mcy7880/MxL5007-and-STM32F407-SDR-receiver/Doc/block_diagram.pdf

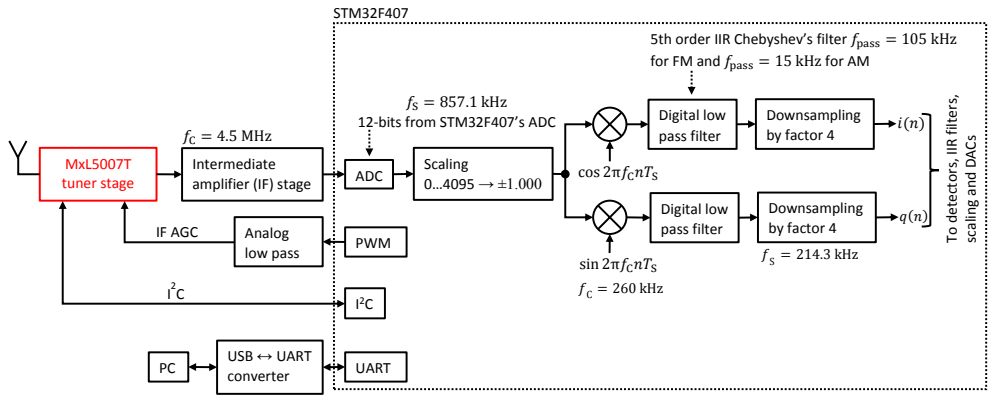
[picture p1: page 1]
MxL5007T tuner stage; ADC; fS = 857.1 kHz; cos 2πfCnTS; Digital low pass filter; Downsampling by factor 4; iሺnሻ; qሺnሻ; = 214.3 kHz sin 2πfCnTS; Scaling 0…4095 → ±1.000; = 260 kHz; STM32F407; Analog low pass; PWM; IF AGC; UART; USB ↔ UART converter PC

5th order IIR Chebyshev’s filter fpass = 105 kHz
for FM and fpass = 15 kHz for AM

To detectors, IIR filters,

12-bits from STM32F407’s ADC

fC = 4.5 MHz
Intermediate
amplifier (IF) stage

scaling and DACs
