mcy7880/MxL5007-and-STM32F407-SDR-receiver/Doc/dvb-t_电路图(MSD7818).pdf

VCC5V_PD | 5V_HDMI

## VC5V

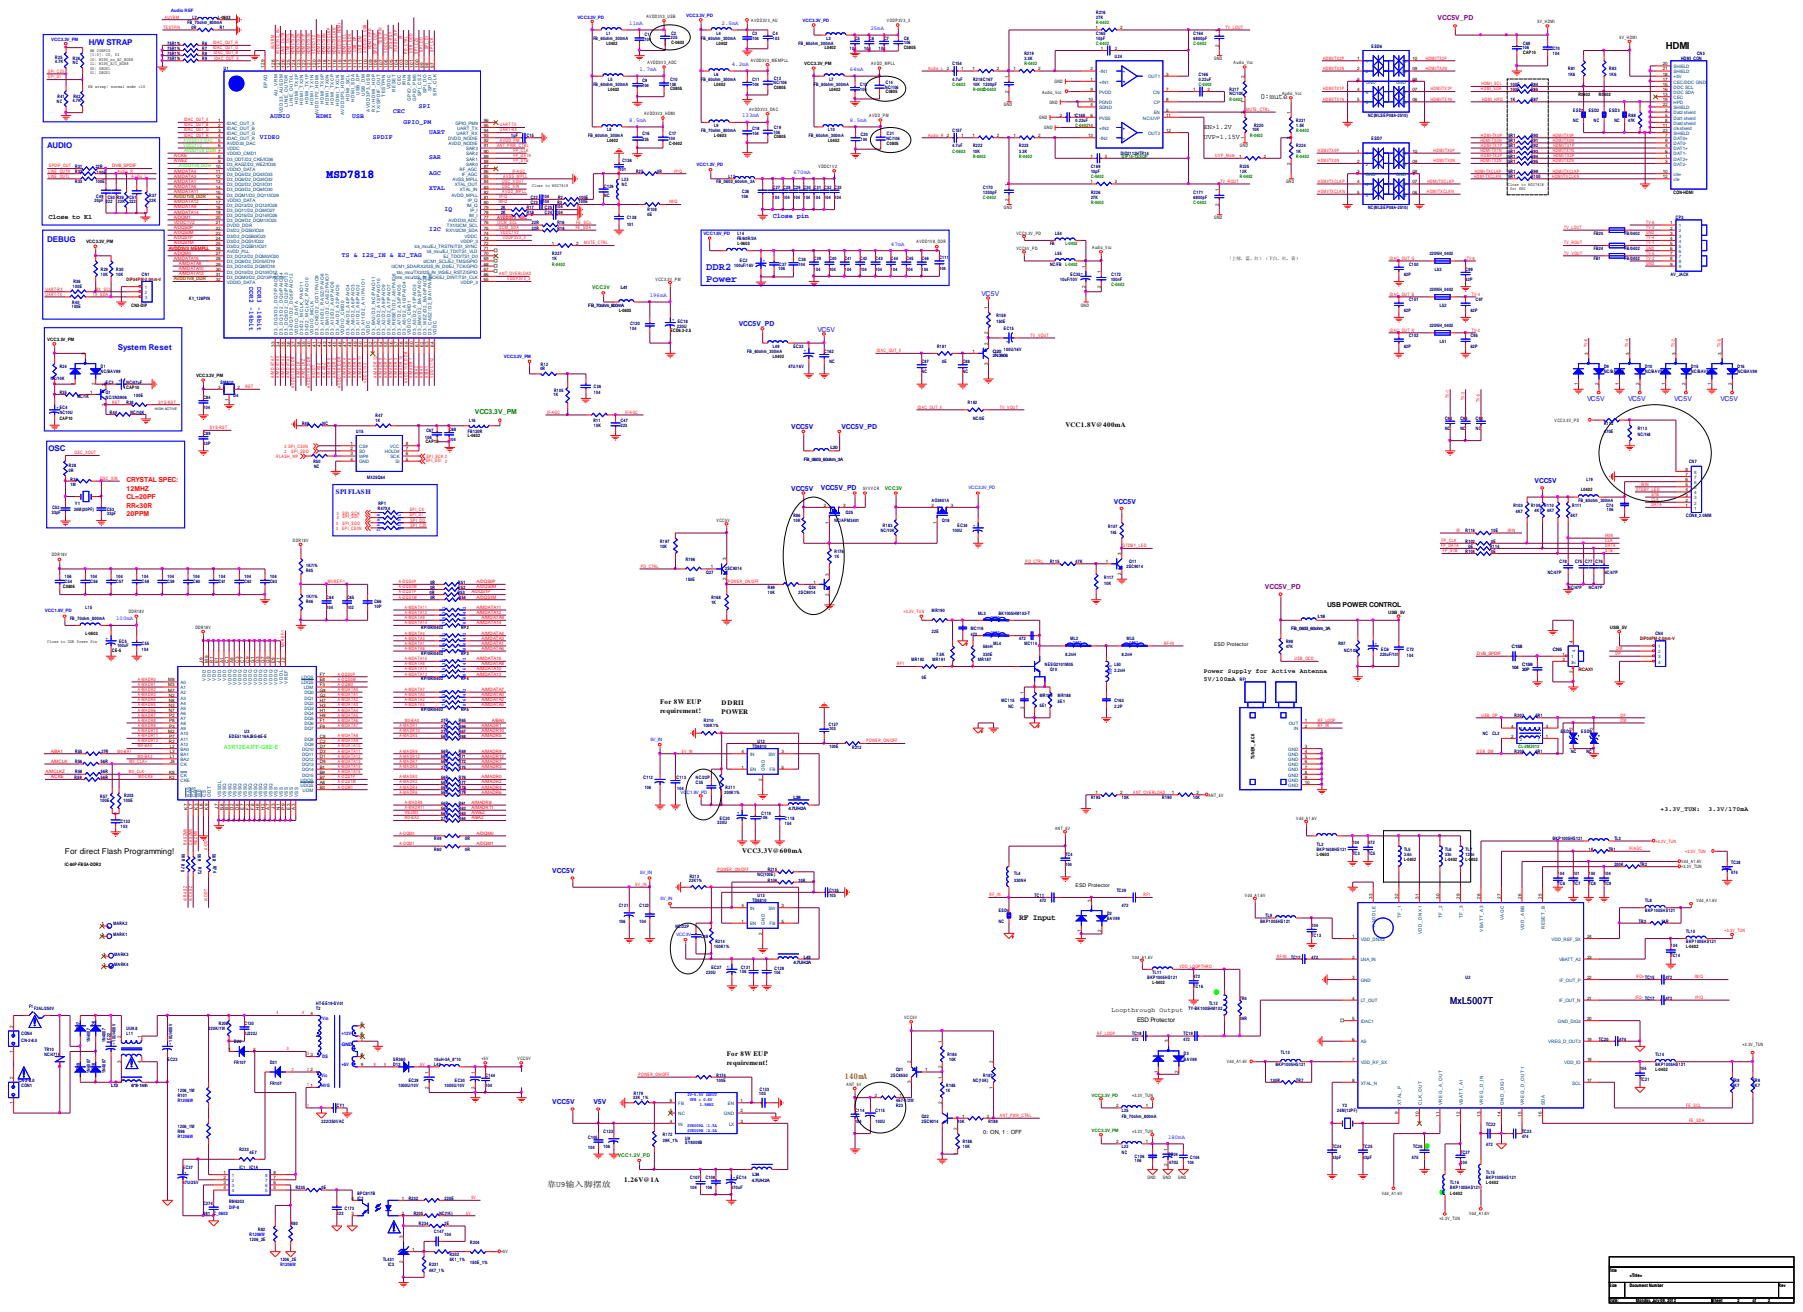
[picture p2: page 1]

HW strap: normal mode =10

Close to DDR Power Pin

VDDQ C7 VDDQ C3 VSSQ D2 VSSQ D8

Power Supply for Active Antenna

For direct Flash Programming!
