mcy7880/MxL5007-and-STM32F407-SDR-receiver/Doc/if_amp_schematic/schematic.pdf

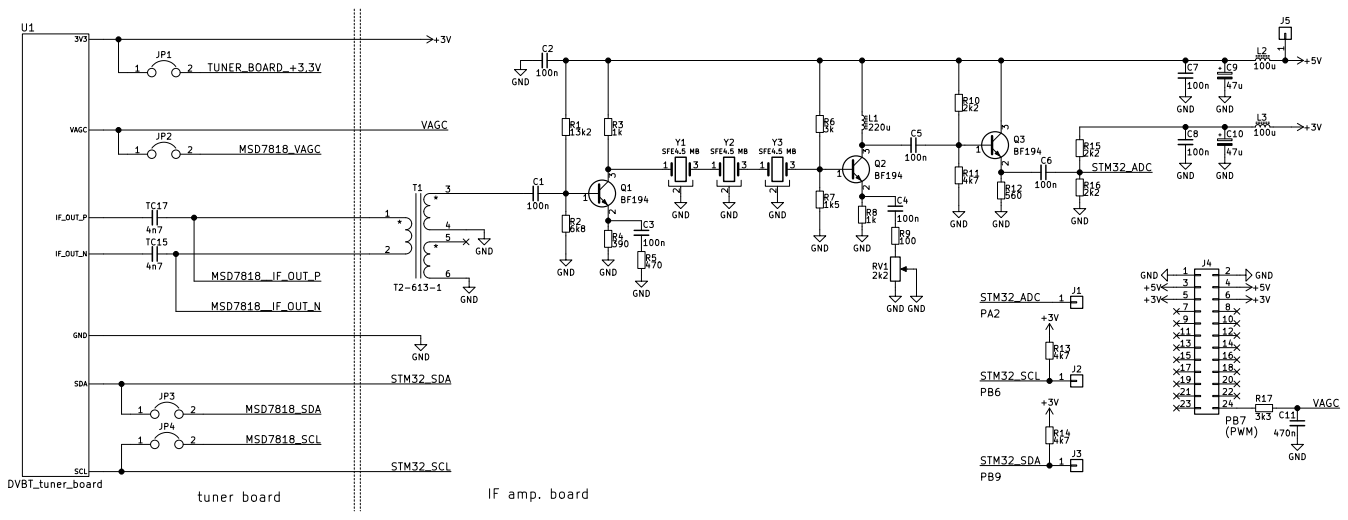
[picture p3: page 1]
