mcy7880/MxL5007-and-STM32F407-SDR-receiver/stm32f407_mxl5007t/Core/Src/main.c

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
/* Includes ------------------------------------------------------------------*/
#include "main.h"

/* USER CODE BEGIN Includes */
#include <string.h>
#include <stdlib.h>
#include <stdio.h>
#include <math.h>
#include <stdbool.h>
#include "led.h"
#include "usart.h"
#include "printf.h"
#include "cmd.h"
#include "MY_CS43L22.h"
#include "MxL5007_Common.h"
#include "MxL5007_API.h"
#include "MxL_User_Define.h"
/* USER CODE END Includes */

ADC_HandleTypeDef hadc1;
DMA_HandleTypeDef hdma_adc1;

DAC_HandleTypeDef hdac;

I2C_HandleTypeDef hi2c1;
I2C_HandleTypeDef hi2c3;

I2S_HandleTypeDef hi2s3;
DMA_HandleTypeDef hdma_spi3_tx;

TIM_HandleTypeDef htim3;
TIM_HandleTypeDef htim4;

UART_HandleTypeDef huart5;

/* USER CODE BEGIN PV */
extern uint8_t rxchar;
int16_t dataI2S[4]; //dummy array for I2S
uint32_t v_in_samples[8]; //IF samples array for ADC

//sine, cosine and arsine look-up tables
float sine_arr[N_cos_sin];
float cosine_arr[N_cos_sin];
float asin_arr[N_asin];

MxL5007_TunerConfigS myTuner; //structure config for MxL5007T

extern Output_demod_type_enum Demod_Type;
extern float b[];
extern float a[];
/* USER CODE END PV */

void SystemClock_Config(void);
static void MX_GPIO_Init(void);
static void MX_DMA_Init(void);
static void MX_I2C1_Init(void);
static void MX_I2S3_Init(void);
static void MX_ADC1_Init(void);
static void MX_TIM3_Init(void);
static void MX_I2C3_Init(void);
static void MX_DAC_Init(void);
static void MX_UART5_Init(void);
static void MX_TIM4_Init(void);
/**
  * @brief  The application entry point.
  * @retval int
  */
int main(void)
{
  /* USER CODE BEGIN 1 */
	//uint8_t regs[32], reg;
	int rxchar_loc;
	uint32_t tick;
  /* USER CODE END 1 */

  /* MCU Configuration--------------------------------------------------------*/

  /* Reset of all peripherals, Initializes the Flash interface and the Systick. */
  HAL_Init();

  /* Configure the system clock */
  SystemClock_Config();

  /* Initialize all configured peripherals */
  MX_GPIO_Init();
  MX_DMA_Init();
  MX_I2C1_Init();
  MX_I2S3_Init();
  MX_ADC1_Init();
  MX_TIM3_Init();
  MX_I2C3_Init();
  MX_DAC_Init();
  MX_UART5_Init();
  MX_TIM4_Init();
  /* USER CODE BEGIN 2 */

  usart_init(&huart5);
  HAL_UART_Receive_IT(&huart5, (uint8_t*) &rxchar, 1);

  /* Startup message */
  UART_printf("\r\n");
  UART_printf("+--------------------------------------+\r\n");
  UART_printf("|     Experimental SDR receiver        |\r\n");
  UART_printf("| based on the STM32F407 and MxL5007T. |\r\n");
  UART_printf("+--------------------------------------+\r\n");

  //init MXL5007T
  myTuner.I2C_Addr = MxL_I2C_ADDR_96; //Set Tuner's I2C Address
  myTuner.Mode = MxL_MODE_DVBT;
  //myTuner.IF_Diff_Out_Level = -8; //Setting for Cable mode only
  myTuner.Xtal_Freq = MxL_XTAL_24_MHZ; //Set Tuner's XTAL freq
  myTuner.IF_Freq = MxL_IF_4_5_MHZ; //Set Tuner's IF Freq
  myTuner.ClkOut_Setting = MxL_CLKOUT_DISABLE; //Set Tuner's Clock out setting
  myTuner.ClkOut_Amp = MxL_CLKOUT_AMP_0;

  HAL_Delay(300); //Without delay after power up MxL5007 doesn't give ACK.
  MxL5007_ChipVersion MxL_ChipVersion = MxL_Check_ChipVersion(&myTuner);
  MxL_Print_ChipVersion(MxL_ChipVersion);
  if (MxL_ChipVersion == MxL_UNKNOWN_ID) MxL_TIMEOUT_UserCallback();

  MxL_ERR_MSG MxL_Status = MxL_Tuner_Init(&myTuner);
  if (MxL_Status != MxL_OK) MxL_TIMEOUT_UserCallback();

  MxL_Status = MxL_Tuner_RFTune(&myTuner, 100*MHz, MxL_BW_6MHz);
  if (MxL_Status != MxL_OK) MxL_TIMEOUT_UserCallback();

  //Check Lock Status
  bool RFSynthLock, REFSynthLock;
  MxL_Status = MxL_RFSynth_Lock_Status(&myTuner, &RFSynthLock);
  if (MxL_Status != MxL_OK) MxL_TIMEOUT_UserCallback();

  MxL_Status = MxL_REFSynth_Lock_Status(&myTuner, &REFSynthLock);
  if (MxL_Status != MxL_OK) MxL_TIMEOUT_UserCallback();

  UART_printf("rfLock=%d   refLock=%d\r\n", RFSynthLock, RFSynthLock);
  UART_printf("MxL5007T initialized.\r\n");

  HAL_TIM_PWM_Start(&htim4, TIM_CHANNEL_2); //starting PWM for IF_AGC pin voltage settings
  MxL_SetGain(75.0 - (IF_Gain + Attenuation)); //total gain 75 dB

  //init CS43L22
  CS43_Init(hi2c1, MODE_ANALOG_);
  CS43_SetVolume(CS43_default_vol); //maximum value without distortion for 3.00 Vpp from DAC is CS43_default_vol=48 for DISCOVERY BOARD
  CS43_Enable_RightLeft(CS43_RIGHT_LEFT);
  CS43_Start();
  UART_printf("CS43L22 initialized.\r\n");

  //TIM3_clk=84 MHz; ARR=98 -> FS_uint_kHz=ceil(TIM3_clk*1000/ARR)=858 kHz
  //F_IF=260 kHz after band pass sampling
  //FS_uint_kHz/F_IF=858/260=33/10 so Step_cos_sin=10 is step and after that is adding modulo N_cos_sin=33 k=mod(k+Step_cos_sin, N_cos_sin)
  float dx = 2.0*M_PI / N_cos_sin; //N_cos_sin=33 samples per sine/cosine period is enough
  uint8_t k = 0;
  for (uint8_t i=0; i<N_cos_sin; i++)
  {
	  sine_arr[i] = sinf(dx*k); //calculating look-up tables with reordering
	  cosine_arr[i] = cosf(dx*k);
	  k = (k + Step_cos_sin) % N_cos_sin; //adding modulo N_cos_sin=33 - unnecessary during real time computing so it can be replace just by counter increment
  }

  dx = 2.0 / N_asin; //step 1-(-1) / N_asin
  for (uint8_t i=0; i<N_asin; i++) asin_arr[i] = asinf(dx*i - 1.0); //calculating look-up table for arsine (needed for FM)

  set_IQ_filters_coeff(b, a, Demod_Type);

  HAL_DAC_Start(&hdac, DAC_CHANNEL_1);
  HAL_DAC_Start(&hdac, DAC_CHANNEL_2);
  HAL_I2S_Transmit_DMA(&hi2s3, (uint16_t *)dataI2S, 4); //starting I2S 16-bits dummy words sending with circular buffer just for MCLK clock for CS43L22

  HAL_TIM_Base_Start(&htim3); //starting timer for ADC triggering
  HAL_ADC_Start_DMA(&hadc1, v_in_samples, 8); //starting DMA for ADC with circular buffer

  /* USER CODE END 2 */

  /* Infinite loop */
  /* USER CODE BEGIN WHILE */
  init_cmd();
  tick = HAL_GetTick() + 100;
  while (1)
  {
    /* USER CODE END WHILE */

    /* USER CODE BEGIN 3 */

	/* UART command processing */
	if((rxchar_loc = usart_getc())!= EOF)
	{
		/* Parse commands */
		cmd_parse(rxchar_loc);
	}

	/* nonblocking wait to flash light */
	if(tick < HAL_GetTick())
	{
		  led_toggle(LED1);
		  tick = HAL_GetTick() + 100;
	}

  }
  /* USER CODE END 3 */
}

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
