mcy7880/MxL5007-and-STM32F407-SDR-receiver/stm32f407_mxl5007t/Core/Inc/main.h

#define IF_Gain         16.95 //dB - measured IF amplifier gain for fc=4.5 MHz
#define Attenuation     -5.46 //dB - tuner's output is loaded by IF amplifier input so it obliviously tends to decrease gain (it was measured)
#define MxL_max_Gain    90.0  //dB - assumption
#define Total_Gain_max  MxL_max_Gain + IF_Gain + Attenuation
#define N_cos_sin    33 //see comments in main.c
#define Step_cos_sin 10
#define N_asin 150
#define b0__105kHz 5.59802632778882980346679687500000e-04
#define b1__105kHz 2.79901339672505855560302734375000e-03
#define b2__105kHz 5.59802679345011711120605468750000e-03
#define b3__105kHz 5.59802679345011711120605468750000e-03
#define b4__105kHz 2.79901339672505855560302734375000e-03
#define b5__105kHz 5.59802632778882980346679687500000e-04
#define a0__105kHz -3.78060984611511230468750000000000e+00
#define a1__105kHz 6.29705619812011718750000000000000e+00
#define a2__105kHz -5.68249320983886718750000000000000e+00
#define a3__105kHz 2.76533651351928710937500000000000e+00
#define a4__105kHz -5.81376254558563232421875000000000e-01
#define b0__15kHz 3.95331483105110237374901771545410e-08
#define b1__15kHz 1.97665755763409833889454603195190e-07
#define b2__15kHz 3.95331511526819667778909206390381e-07
#define b3__15kHz 3.95331511526819667778909206390381e-07
#define b4__15kHz 1.97665755763409833889454603195190e-07
#define b5__15kHz 3.95331483105110237374901771545410e-08
#define a0__15kHz -4.90738058090209960937500000000000e+00
#define a1__15kHz 9.64835929870605468750000000000000e+00
#define a2__15kHz -9.49977493286132812500000000000000e+00
#define a3__15kHz 4.68406248092651367187500000000000e+00
#define a4__15kHz -9.25264954566955566406250000000000e-01
#define LED_LD4_Pin GPIO_PIN_12
#define LED_LD4_GPIO_Port GPIOD
#define TEST_Pin GPIO_PIN_15
#define TEST_GPIO_Port GPIOD
#define CS43L22_reset_Pin GPIO_PIN_4
#define CS43L22_reset_GPIO_Port GPIOD
#define SCL_Pin GPIO_PIN_6
#define SCL_GPIO_Port GPIOB
#define SDA_Pin GPIO_PIN_9
#define SDA_GPIO_Port GPIOB
