mcy7880/MxL5007-and-STM32F407-SDR-receiver/stm32f407_mxl5007t/Core/Src/printf.c

//02-08-2025 - Maciej Fajfer

#include "printf.h"
#include "usart.h"

static char UART_printf_tmp_buf[150];

void UART_printf(const char *format, ...)
{
   va_list args;
   va_start(args, format);
   vsprintf(UART_printf_tmp_buf, format, args);
   va_end(args);

   char *tmp_pointer = UART_printf_tmp_buf;
   while(*tmp_pointer != '\0') usart_putc(0, *tmp_pointer++);
}
